BrnoMarsRover/myMachine-LED-cap/README.md

# myMachine-LED-cap
Repository for my Machine LED Cap project, including software, PCBs, and documentation.
