BrnoMarsRover/myMachine-LED-cap/docs/hardware/komponenty.md

## Komponenty
Všechny komponenty potřebné pro realizaci jedné LED kšiltovky. BOM pro desku plošných spojů bude generovat Kicad, proto je nebude zapisovat do této tabulky.

Primárně je snaha všechny komponenty vybírat z obchodu Mouser.com a LaskaKit.cz.

## Tabulka komponent
| Název | Obchod | Množství | Cena (ks) | Cena celkem | Poznámka |
|---|---|---|---|---|---|
|Kšitovka|-|-|-|-|Libovolně|
|[Displej](https://www.laskakit.cz/en/4-0--480x320-tft-displej--st7796--spi--dotykovy/)|LaskaKit|1|598 Kč|598 Kč|LA141073|
|[LED Neopixel](https://www.laskakit.cz/en/led-pasek-neopixel-ws2812b-144led-m-ip65-1m-cerny/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)|LaskaKit|1,2 m|488 Kč|586 Kč|LA145022F|
|[Motor](https://www.laskakit.cz/en/modul-ventilatoru-l9110/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)|LaskaKit|1|58 Kč|58 Kč|LA143011|
|[Switch](https://cz.mouser.com/ProductDetail/E-Switch/RD151C112F?qs=QtyuwXswaQg7j8DbOZUpHw%3D%3D)|Mouser electronics|1|19,81 Kč|19,81 Kč|612-RD151C112F|
|[Bateriový box](https://www.laskakit.cz/bateriovy-box-1x18650-dratove-vyvody/)|LaskaKit|2|12 Kč|24 Kč|LA123057|
|[Baterie Li-Ion](https://www.laskakit.cz/geb-li-ion-baterie-18650-3200mah-3-7v/)|LaskaKit|2|158 Kč|316 Kč|LA123134|
|[Dual-Lock zip](https://www.3market.cz/sj-3870-samolepici-suchy-zip-3m-dual-lock--lepeni-kovu--povrchu-s-praskovymi-laky--plastu-typu-plexiskla--polykarbonatu-a-abs--cena-za-bezny-m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)|3market|1 m|108,4 Kč|108,4 Kč|7100214419|
|[Vložka se závitem](https://cz.mouser.com/ProductDetail/SI/IUTB-M2.5?qs=7MVldsJ5UaxaLK8FbVq%252B7A%3D%3D)|Mouser electronics|8|9 Kč|72 Kč|153-IUTB-M2.5|
|[Distanční sloupek](https://cz.mouser.com/c/electromechanical/hardware/standoffs-spacers/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)|Mouser electronics|8|10 Kč|80 Kč|nutné doladit výšku podle možností  výrobku|
|-|-|-|-|-|-|

### Nabíjení
Nabíjení vybraných baterií bude probíhat externě. Může se koupit jakákoliv nabíječka na Li-Ion baterie jako například [zde](https://www.alza.cz//alzapower-usb-battery-charger-ap450b-d6154186.htm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), cena orietačně 700 - 800 Kč. Bude však stačit jedna nabíječka pro všechny kšiltovky.
