BrnoMarsRover/myMachine-LED-cap/docs/hardware/top_board/top_board.md

# Top board

## BOM

[Otevřít interaktivní BOM](ibom.html)

## Schéma

[Otevřít schéma](schematic_v0.0.pdf)

## Popis

Horní deska slouží ke dvěma účelům - zaprvé drží motor, zadruhé jsou na ní konektory k motoru a k ledpáskům.

Konektory jsou typu JST-XH. Samice se zapájí do desky. Samce bude potřeba nakrimpovat. 

Bude použit tento [motor](https://www.laskakit.cz/ga12-n20-6v-motor-s-prevodovkou/?variantId=1853) . Případně s podrobnějším výkresem [zde](https://www.aliexpress.com/item/1005010029527576.html). Na výstup převodovky se umístí vrtulka, která se pravděpodobně vytiskne. Zespodu má motor dva vývody, kterými bude připájen k desce. Mezi vývody je ale výstupek. Uprostřed desky tedy bude muset být otvor, kterým výstupek projde. Okraje otvoru budou zasahovat poměrně blízko k dírám pro připájení vývodů motoru. Kicad projekt s navrženou deskou je ve složce pcbs. Pokud by se objevil problém s deskou, jsem připraven pomoct s jeho řešením.
