BrnoMarsRover/myMachine-LED-cap/docs/updates.md

## 25.2.2026
Před osazovaním step-up modulu jej prosím nastavte tak, aby výstupní napětí bylo 5V [dle tohoto návodu](https://www.laskakit.cz/step-up-boost-menic-s-mt3608/).
```
Vyvarujte se stavu kdy je na vstupních svorkách vyšší napětí než nastavené na výstupních! Může dojít k poškození měniče!
Před prvním použitím je tedy nutné použít vstupní napětí 2V a nastavit požadované výstupní napětí. Potom lze na vstup připojit zamýšlené vyšší vstupní napětí.
```

## 19.2.2026
Až dorazí na plošné spoje a součástky (očekávám je tento možná příští týden). Je na střední škole, aby

- DPS osadila, doporučuji při osazovaní využívat iBOM, které je v dokumentaci k dispozici.
- Připravila všechny konektory (baterie, displej, LED pásek, motor ...) tak aby šel hardware testovat.

Jakmile bude hardware připraven vyzvedneme si ho a otestujeme. Proto prosím tyto kroky zbytečně neodkládat, ať se případné chyby v hardwaru mohou ještě opravit.

Mezi tím si potom střední škola může připravovat první prototyp kšitovky

- Tisk dílů ve fusion modelu (Možná ale budou upraveny po testování).
- Přišití suchých zipů na kšiltovku.
- Pokud by byl nějaký dobrovolník co by si chtěl vyzkoušet ten automatický šicí stroj ve FabLabu, tak se na kšitovku může vyšít nějaké pěkné logo.

## 11.2.2026
Byly objednány první verze DPS z obchodu JLCPCB. Byla objednána i deska top_board, jelikož cena byla pár dolarů navíc. Avšak stále se preferuje vyrobená varianta na střední škole.
