BrnoMarsRover/myMachine-LED-cap/docs/index.md

# My Machine LED kšiltovka

Vítej v dokumentaci projektu My Machine LED kšiltovka. Zde budeme postupně vkládat všechny potřebné materiály k tomuto projektu.

Všechny soubory k projektu budou k dispozici v našem githubovém repozitáři [BrnoMarsRover/myMachine-LED-cap](https://github.com/BrnoMarsRover/myMachine-LED-cap.git). Pro jeho stažení stačí rozkliknout zelené tlačítko 'code' a zvolit 'stáhnout zip'.

## Autoři
- Martin Kříž
- Martin Majnuš
- Vilém Strachoň
- Filip Šlíma
- Ondřej Štafa
