BrnoMarsRover/myMachine-LED-cap/docs/software/example.md

## Ukázka
Ukázkový kód pro ESP32 webserver je v [software/web-server-example](https://github.com/BrnoMarsRover/myMachine-LED-cap/tree/main/software/web-server-example).

## [Web pro ovládání kšiltovky](web_ukazka.html)

## Inspirace

- [https://www.youtube.com/watch?v=z-I-r3PX2lU](https://www.youtube.com/watch?v=z-I-r3PX2lU)
- [https://randomnerdtutorials.com/esp32-web-server-arduino-ide/](https://randomnerdtutorials.com/esp32-web-server-arduino-ide/)
