BrnoMarsRover/myMachine-LED-cap/docs/images/esp_pinout.jpg

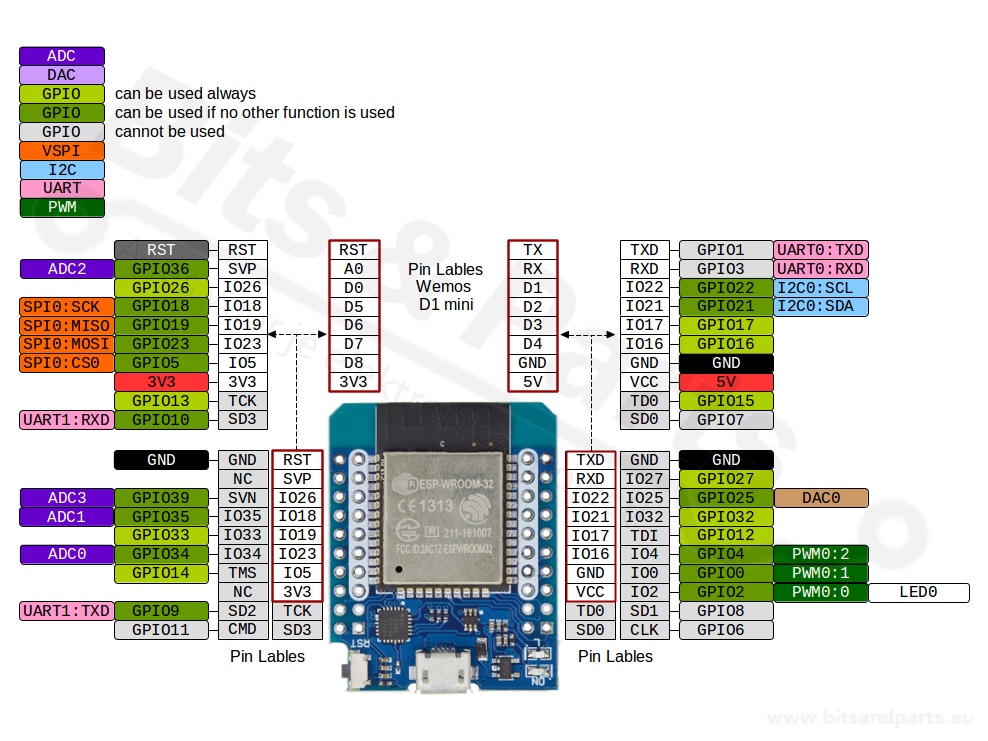
docs/images/esp_pinout.jpg
