BrnoMarsRover/myMachine-LED-cap/docs/construction/druhy_nakup.md

## Druhý nákup – LaskaKit

> **Doručit: střední škola**

Položky z obchodu [LaskaKit.cz](https://www.laskakit.cz) potřebné pro realizaci jedné LED kšiltovky.

## Tabulka komponent

| Název | Množství | Cena (ks) | Cena celkem | Kód | Poznámka |
|---|---|---|---|-----|---|
|[ESP32 Kit](https://www.laskakit.cz/en/mh-et-live-esp32-minikit--wemos-d1-mini-shield-kompatibilni/)|2|198 Kč|396 Kč|LA100089||
|[Displej](https://www.laskakit.cz/en/4-0--480x320-tft-displej--st7796--spi--dotykovy/)|2|598 Kč|1 196 Kč|LA141073||
|[LED Neopixel](https://www.laskakit.cz/en/led-pasek-neopixel-ws2812b-144led-m-ip65-1m-cerny/)|2 m|488 Kč/m|976 Kč|LA145022F||
|[Bateriový box](https://www.laskakit.cz/bateriovy-box-1x18650-dratove-vyvody/)|4|12 Kč|48 Kč|LA123057||
|[Baterie Li-Ion](https://www.laskakit.cz/geb-li-ion-baterie-18650-3200mah-3-7v/)|4|158 Kč|632 Kč|LA123134||
|[Krimpovací pin](https://www.laskakit.cz/pin-pro-konektor-jst-xh/)|100|1 Kč|100 Kč|LA217022||
|[Dupont lišta](https://www.laskakit.cz/yxcon-p125-1140a0bs116a1-dupont-kolikova-lista-40pin-2-54mm-pozlacena-jednorada-prima/)|2|14 Kč|28 Kč|LA217089B||

**Celkem: 3 376 Kč**

---

## 3market.cz

> **Doručit: střední škola**

| Název | Množství | Cena (bm) | Cena celkem | Kód |
|---|---|---|---|-----|
|[Dual-Lock zip](https://www.3market.cz/sj-3870-samolepici-suchy-zip-3m-dual-lock--lepeni-kovu--povrchu-s-praskovymi-laky--plastu-typu-plexiskla--polykarbonatu-a-abs--cena-za-bezny-m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)|4 m|108,4 Kč|433,6 Kč|7100214419|

**Celkem: 433,6 Kč**

---

## feromat.cz

> **Doručit: tým VUT**

| Název | Množství | Cena (ks) | Cena celkem | Poznámka |
|---|---|---|---|---|
|[Tavný závit M3 vysoký 3mm](https://www.tme.eu/cz/details/kvt-0006m3/zavitove-vlozky/tappex/0006m3/)|40|-|-|Display box|
|[Šroub M3 14mm](https://shop.feromat.cz/index.php?IdP=18&Akce=Obj&Hodnota=15000000035643&IdVyhlSloz=15000000039723)|20|-|-|Display box|
|[Distanční sloupek samice M3 8mm](https://www.tme.eu/cz/details/tff-m3x8_dr113bk/distancni-prvky-kovove/dremec/113x08sw/)|20|-|-|Display box|
|[Šroub M3 6mm zapuštěný](https://shop.feromat.cz/index.php?IdP=18&Akce=Obj&Hodnota=15000000039581&IdVyhlSloz=15000000227729)|10|-|-|Display box – Zdebjan řekne|
|[Matka M3](https://shop.feromat.cz/index.php?IdP=18&Akce=Obj&Hodnota=15000000034929&IdVyhlSloz=15000000908352)|10|-|-|Display box|
|[Šroub M3 6mm](https://shop.feromat.cz/index.php?IdP=18&Akce=Obj&Hodnota=15000000036193&IdVyhlSloz=15000000039723)|20|-|-|Display box|
|[Šroub M3 14mm](https://shop.feromat.cz/index.php?IdP=18&Akce=Obj&Hodnota=15000000035643&IdVyhlSloz=15000000039723)|15|-|-|Top box|
|[Matka M3](https://shop.feromat.cz/index.php?IdP=18&Akce=Obj&Hodnota=15000000034929&IdVyhlSloz=15000000908352)|15|-|-|Top box|
|[Podložka M3](https://shop.feromat.cz/index.php?IdP=18&Akce=Obj&Hodnota=15000000035422&IdVyhlSloz=15000000035418)|15|-|-|Top box|

---

## Nákupní košík – Mouser

> **Doručit: tým VUT**

[Otevřít sdílený košík na Mouser.com](https://cz.mouser.com/api/CrossDomain/GetContext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)
