BrnoMarsRover/myMachine-LED-cap/docs/construction/komponenty.md

## Komponenty
Všechny komponenty potřebné pro realizaci jedné LED kšiltovky. Seznam součástek pro PCB je k dispozici jako odkaz v tabulce komponent.

Primárně je snaha všechny komponenty vybírat z obchodu Mouser.com a LaskaKit.cz. A dodatečně byl ještě přidán obchod TME.eu

## Tabulka komponent
| Název | Obchod | Množství | Cena (ks) | Cena celkem | Poznámka |
|---|---|---|---|---|---|
|[Kšiltovka](https://www.bezpotisku.cz/produkt/ksiltovka-buzz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)|Bezpotisku|1|99 Kč|99 Kč|Může být i jiná|
|[Displej](https://www.laskakit.cz/en/4-0--480x320-tft-displej--st7796--spi--dotykovy/)|LaskaKit|1|598 Kč|598 Kč|LA141073|
|[LED Neopixel](https://www.laskakit.cz/en/led-pasek-neopixel-ws2812b-144led-m-ip65-1m-cerny/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)|LaskaKit|1,2 m|488 Kč|586 Kč|LA145022F (kupme 2m)|
|[Bateriový box](https://www.laskakit.cz/bateriovy-box-1x18650-dratove-vyvody/)|LaskaKit|2|12 Kč|24 Kč|LA123057|
|[Baterie Li-Ion](https://www.laskakit.cz/geb-li-ion-baterie-18650-3200mah-3-7v/)|LaskaKit|2|158 Kč|316 Kč|LA123134|
|[Krimpovací pin](https://www.laskakit.cz/pin-pro-konektor-jst-xh/)|LaskaKit|50|1 Kč|50 Kč|LA217022|
|[Dupont lišta](https://www.laskakit.cz/yxcon-p125-1140a0bs116a1-dupont-kolikova-lista-40pin-2-54mm-pozlacena-jednorada-prima/)|LaskaKit|1|14 Kč|14 Kč|LA217089B|
|[Nabíječka](https://www.laskakit.cz/en/nabijecka-liitokala-lii-pd4-pro-li-ion--li-fe-a-ni-mh-baterie/)|LaskaKit|1|668|668|LA123099|
|[Dual-Lock zip](https://www.3market.cz/sj-3870-samolepici-suchy-zip-3m-dual-lock--lepeni-kovu--povrchu-s-praskovymi-laky--plastu-typu-plexiskla--polykarbonatu-a-abs--cena-za-bezny-m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)|3market|2 m|108,4 Kč|216,8 Kč|7100214419|
|[Switch](https://cz.mouser.com/ProductDetail/E-Switch/RD151C112F?qs=QtyuwXswaQg7j8DbOZUpHw%3D%3D)|Mouser|1|19,81 Kč|19,81 Kč|612-RD151C112F|
|[Vložka se závitem](https://cz.mouser.com/ProductDetail/SI/IUTB-M2.5?qs=7MVldsJ5UaxaLK8FbVq%252B7A%3D%3D)|Mouser|8|9 Kč|72 Kč|153-IUTB-M2.5|
|[Distanční sloupek](https://cz.mouser.com/c/electromechanical/hardware/standoffs-spacers/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)|Mouser|8|10 Kč|80 Kč|zatím nekupovat|
|[Plochý kabel](https://cz.mouser.com/ProductDetail/3M-Electronic-Solutions-Division/3302-10-CUT-LENGTH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)|Mouser|3|17 Kč|51 Kč|517-3302/10FT|
|[BOM Main PCB](../hardware/main_board/ibom.html)|Mouser/LaskaKit|1|-|1064 Kč|BOM generované v KiCad *|
|[BOM Top PCB](../hardware/top_board/ibom.html)|Mouser/LaskaKit|1|-|121 Kč|BOM generované v KiCad|
|[8 pin JST-XH](https://www.tme.eu/cz/details/xhp-8/signalove-konektory-raster-2-50mm/jst/)|TME|1|2,06 Kč|2,06 Kč|XHP-8|
|[3 pin JST-XH](https://www.tme.eu/cz/details/xhp-3/signalove-konektory-raster-2-50mm/jst/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)|TME|5|1,46 Kč|7,3 Kč|XHP-3|
|[2 pin JST-XH](https://www.tme.eu/cz/details/xhp-2/signalove-konektory-raster-2-50mm/jst/)|TME|5|1,17 Kč|5,85 Kč|XHP-2|
|Display box|-|1|-|-|3D tisk|
|Main PCB|-|1|-|-|Objedná se|
|Top box|-|1|-|-|3D tisk|
|Top PCB|-|1|-|-|Vyrobí se|
|-|-|-|-|-|-|

- *Pojistku (652-SF-0603F500-2) je vhodné zakoupit alespoň 5x

### Nabíjení
Nabíjení vybraných baterií bude probíhat externě. Může se koupit jakákoliv nabíječka na Li-Ion baterie jako například [zde](https://www.laskakit.cz/en/nabijecka-liitokala-lii-pd4-pro-li-ion--li-fe-a-ni-mh-baterie/), cena orietačně 700 - 800 Kč. Bude však stačit jedna nabíječka pro všechny kšiltovky.
