BrnoMarsRover/myMachine-LED-cap/docs/hardware/top_board/schematic_v0.0.pdf

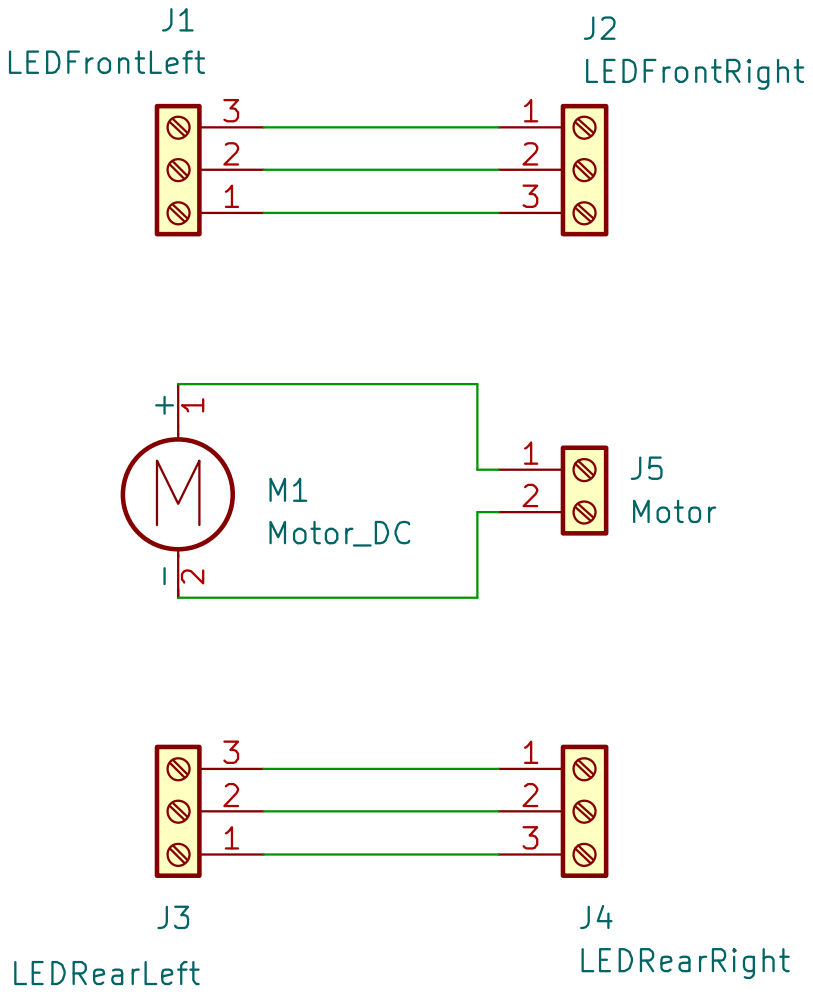
[picture p5: page 1]
