BrnoMarsRover/myMachine-LED-cap/pcbs/top_board/tob_board/tob_board.kicad_pcb

## KiCad design pcbs/top_board/tob_board/tob_board.kicad_pcb (2026-03-12)

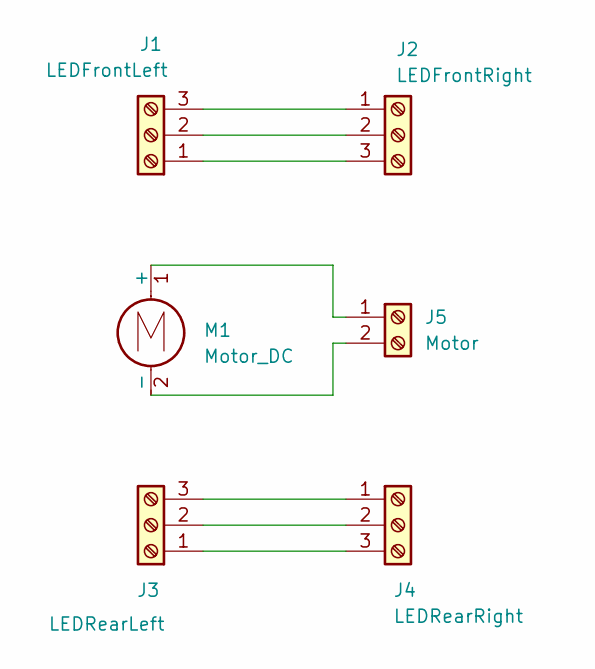
[picture p12: schematic tob_board.kicad_sch, Top board - MyMachine LED cap]

Parts:
J1: LEDFrontLeft; JST_XH_S3B-XH-A_1x03_P2.50mm_Horizontal; Manufacturer Part Number S3B-XH-A-1 (LF)(SN)
J2: LEDFrontRight; JST_XH_S3B-XH-A_1x03_P2.50mm_Horizontal; Manufacturer Part Number S3B-XH-A-1 (LF)(SN)
J3: LEDRearLeft; JST_XH_S3B-XH-A_1x03_P2.50mm_Horizontal; Manufacturer Part Number S3B-XH-A-1 (LF)(SN)
J4: LEDRearRight; JST_XH_S3B-XH-A_1x03_P2.50mm_Horizontal; Manufacturer Part Number S3B-XH-A-1 (LF)(SN)
J5: Motor; JST_XH_S2B-XH-A_1x02_P2.50mm_Horizontal; Manufacturer Part Number S2B-XH-A-BK(LF)(SN)
M1: Motor_DC; topMotor; Manufacturer Part Number LA143024A

Connections:
unnamed: J1.1, J2.3
unnamed: J1.2, J2.2
unnamed: J1.3, J2.1
unnamed: J3.1, J4.3
unnamed: J3.2, J4.2
unnamed: J3.3, J4.1
unnamed: J5.1, M1.1 (+)
unnamed: J5.2, M1.2 (-)

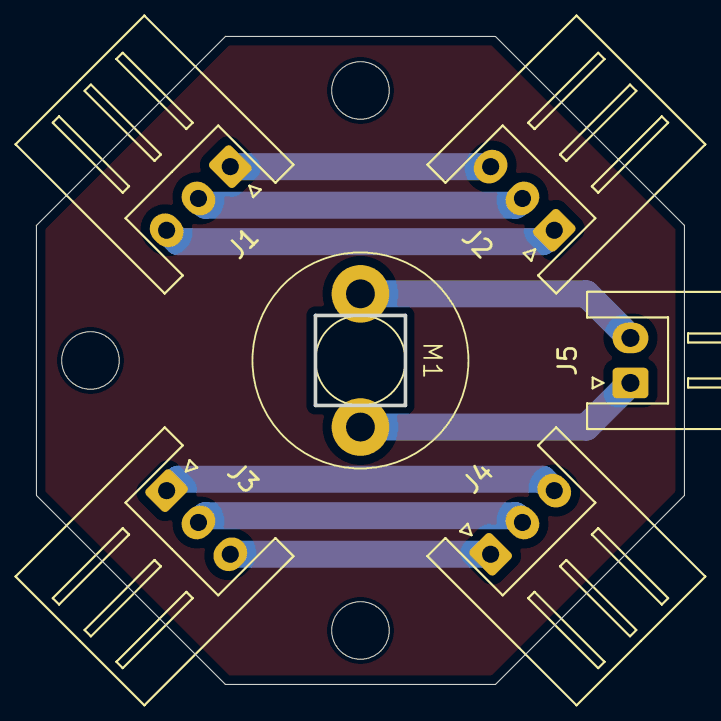
[picture p13: board tob_board.kicad_pcb from above]

Board: 2 copper layers, 36.0 x 36.0 mm, 6 parts (0 on the bottom side), 8 nets.
