BrnoMarsRover/myMachine-LED-cap/pcbs/main_board/main_board.kicad_pcb

## KiCad design pcbs/main_board/main_board.kicad_pcb (2026-03-12)

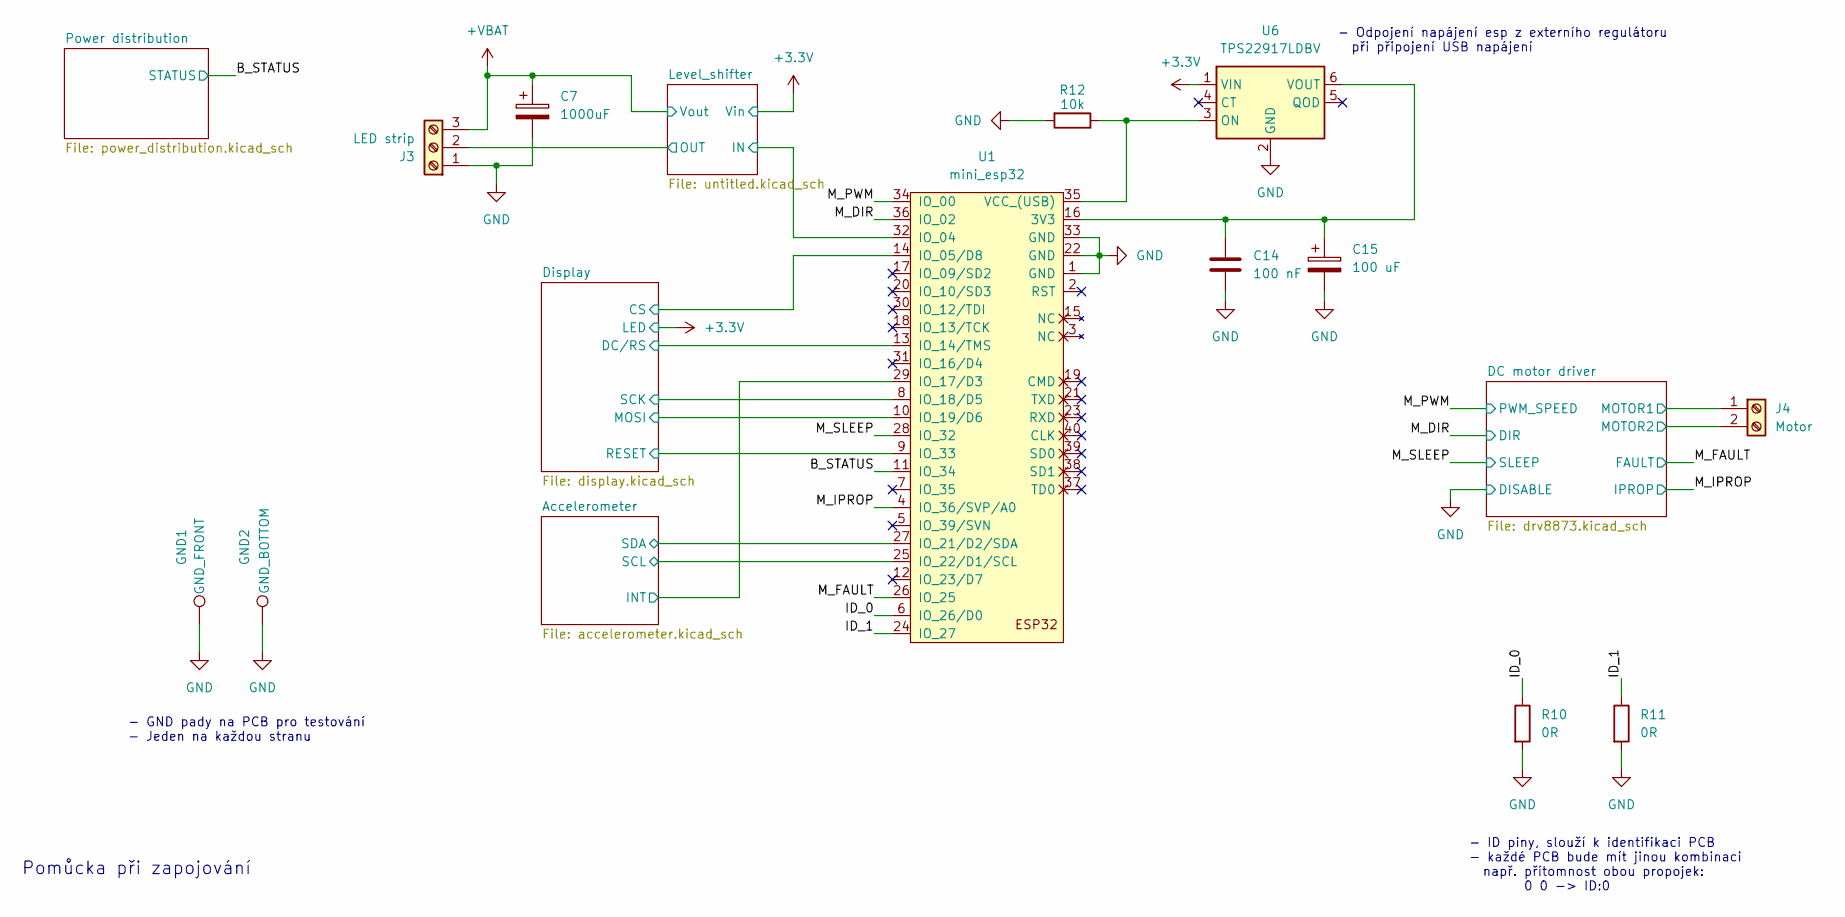
[picture p14: schematic main_board.kicad_sch, Main board - MyMachine LED cap]

Parts:
C7: 1000uF; CP_EIA-7360-38_Kemet-E_HandSolder; Manufacturer Part Number TCN4108M006R0055
C14: 100 nF; C_0603_1608Metric_Pad1.08x0.95mm_HandSolder; Manufacturer Part Number C0603C104M5RACTU
C15: 100 uF; CP_EIA-7343-40_Kemet-Y_HandSolder; Manufacturer Part Number T491X107K016AT7280
GND1: GND_FRONT; TestPoint_Pad_1.5x1.5mm
GND2: GND_BOTTOM; TestPoint_Pad_1.5x1.5mm
J3: LED strip; JST_XH_S3B-XH-A-1_1x03_P2.50mm_Horizontal; Manufacturer Part Number S3B-XH-A-1 (LF)(SN)
J4: Motor; JST_XH_S2B-XH-A-1_1x02_P2.50mm_Horizontal; Manufacturer Part Number S2B-XH-A-BK(LF)(SN)
R10, R11: 0R; R_0603_1608Metric_Pad0.98x0.95mm_HandSolder; Manufacturer Part Number CRCW06030000Z0EI
R12: 10k; R_0603_1608Metric_Pad0.98x0.95mm_HandSolder; Manufacturer Part Number CRCW060310K0FKEI
U1: mini_esp32; ESP32_mini; Manufacturer Part Number LA100089
U6: TPS22917LDBV; SOT-23-6; Manufacturer Part Number TPS22917LDBVR

Connections:
+3.3V: U6.1 (VIN); also elsewhere on the board
+VBAT: C7.1, J3.3; also elsewhere on the board
/Accelerometer/INT: U1.29 (IO_17/D3); also elsewhere on the board
/Accelerometer/SCL: U1.25 (IO_22/D1/SCL); also elsewhere on the board
/Accelerometer/SDA: U1.27 (IO_21/D2/SDA); also elsewhere on the board
/B_STATUS: U1.11 (IO_34); also elsewhere on the board
/DC motor driver/MOTOR1: J4.1; also elsewhere on the board
/DC motor driver/MOTOR2: J4.2; also elsewhere on the board
/Display/CS: U1.14 (IO_05/D8); also elsewhere on the board
/Display/DC/RS: U1.13 (IO_14/TMS); also elsewhere on the board
/Display/MOSI: U1.10 (IO_19/D6); also elsewhere on the board
/Display/RESET: U1.9 (IO_33); also elsewhere on the board
/Display/SCK: U1.8 (IO_18/D5); also elsewhere on the board
/ID_0: R10.1, U1.6 (IO_26/D0)
/ID_1: R11.1, U1.24 (IO_27)
/Level_shifter/IN: U1.32 (IO_04); also elsewhere on the board
/Level_shifter/OUT: J3.2; also elsewhere on the board
/M_DIR: U1.36 (IO_02); also elsewhere on the board
/M_FAULT: U1.26 (IO_25); also elsewhere on the board
/M_IPROP: U1.4 (IO_36/SVP/A0); also elsewhere on the board
/M_PWM: U1.34 (IO_00); also elsewhere on the board
/M_SLEEP: U1.28 (IO_32); also elsewhere on the board
GND: C7.2, C14.2, C15.2, GND1.1, GND2.1, J3.1, R10.2, R11.2, R12.2, U1.1 (GND), U1.22 (GND), U1.33 (GND), U6.2 (GND); also elsewhere on the board
unnamed: C14.1, C15.1, U1.16 (3V3), U6.6 (VOUT)
unnamed: R12.1, U1.35 (VCC_(USB)), U6.3 (ON)

Notes on the sheet:
Pomůcka při zapojování
- Odpojení napájení esp z externího regulátoru při připojení USB napájení
- ID piny, slouží k identifikaci PCB - každé PCB bude mít jinou kombinaci např. přítomnost obou propojek: 0 0 -> ID:0
- GND pady na PCB pro testování - Jeden na každou stranu

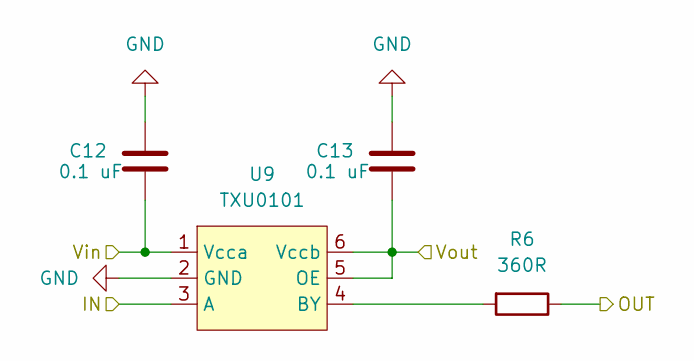
[picture p15: schematic untitled.kicad_sch, Main board - MyMachine LED cap]

Parts:
C12, C13: 0.1 uF; C_0603_1608Metric_Pad1.08x0.95mm_HandSolder; Manufacturer Part Number CC0603JRX7R9BB104
R6: 360R; R_0603_1608Metric_Pad0.98x0.95mm_HandSolder; Manufacturer Part Number CRCW0603360RJNTA
U9: TXU0101; SOT-363_SC-70-6_Handsoldering; Manufacturer Part Number TXU0101DCKR

Connections:
+3.3V: C12.1, U9.1 (Vcca); also elsewhere on the board
+VBAT: C13.1, U9.5 (OE), U9.6 (Vccb); also elsewhere on the board
/Level_shifter/IN: U9.3 (A); also elsewhere on the board
/Level_shifter/OUT: R6.1; also elsewhere on the board
GND: C12.2, C13.2, U9.2 (GND); also elsewhere on the board
unnamed: R6.2, U9.4 (BY)

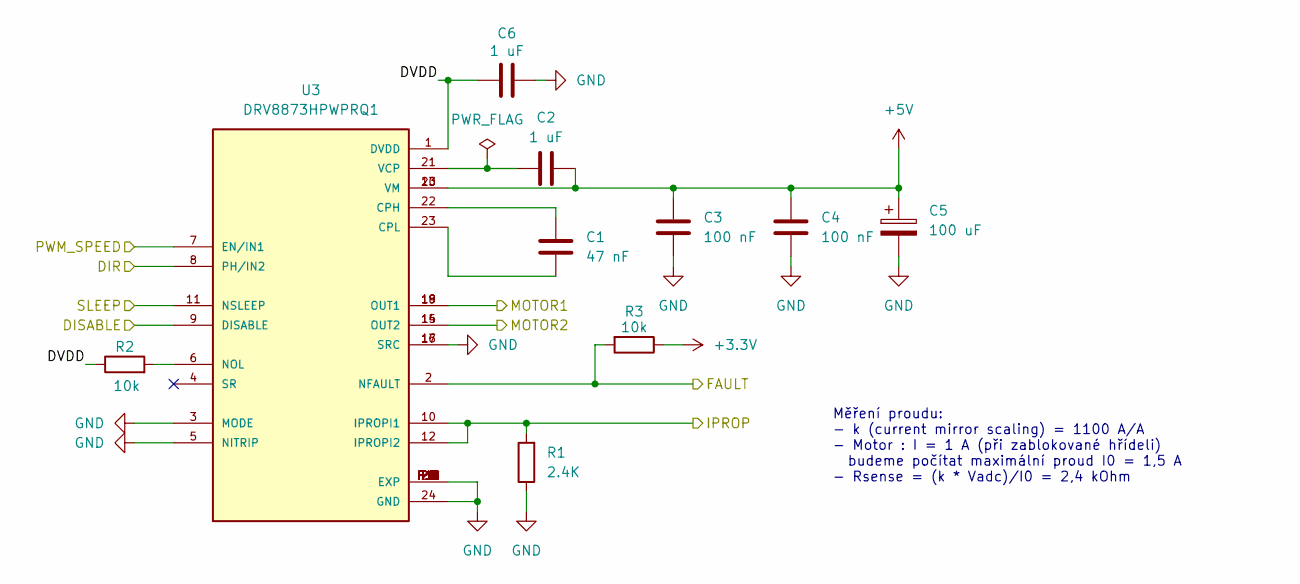
[picture p16: schematic drv8873.kicad_sch, Main board - MyMachine LED cap]

Parts:
C1: 47 nF; C_0603_1608Metric_Pad1.08x0.95mm_HandSolder; Manufacturer Part Number CC0603ZRY5V9BB473
C2, C6: 1 uF; C_0603_1608Metric_Pad1.08x0.95mm_HandSolder; Manufacturer Part Number CC0603KRX5R6BB105
C3, C4: 100 nF; C_0603_1608Metric_Pad1.08x0.95mm_HandSolder; Manufacturer Part Number C0603C104M5RACTU
C5: 100 uF; CP_EIA-7343-40_Kemet-Y_HandSolder; Manufacturer Part Number T491X107K016AT7280
R1: 2.4K; R_0603_1608Metric_Pad0.98x0.95mm_HandSolder; Manufacturer Part Number AR0603JR-072K4L
R2, R3: 10k; R_0603_1608Metric_Pad0.98x0.95mm_HandSolder; Manufacturer Part Number CRCW060310K0FKEI
U3: DRV8873HPWPRQ1; SOP65P640X120-25N; Manufacturer Part Number DRV8873HPWPR

Connections:
+3.3V: R3.1; also elsewhere on the board
+5V: C2.2, C3.1, C4.1, C5.1, U3.13 (VM), U3.20 (VM); also elsewhere on the board
/DC motor driver/DVDD: C6.1, R2.1, U3.1 (DVDD)
/DC motor driver/MOTOR1: U3.18 (OUT1), U3.19 (OUT1); also elsewhere on the board
/DC motor driver/MOTOR2: U3.14 (OUT2), U3.15 (OUT2); also elsewhere on the board
/M_DIR: U3.8 (PH/IN2); also elsewhere on the board
/M_FAULT: R3.2, U3.2 (NFAULT); also elsewhere on the board
/M_IPROP: R1.2, U3.10 (IPROPI1), U3.12 (IPROPI2); also elsewhere on the board
/M_PWM: U3.7 (EN/IN1); also elsewhere on the board
/M_SLEEP: U3.11 (NSLEEP); also elsewhere on the board
GND: C3.2, C4.2, C5.2, C6.2, R1.1, U3.3 (MODE), U3.5 (NITRIP), U3.9 (DISABLE), U3.16 (SRC), U3.17 (SRC), U3.24 (GND), U3.25 (EXP), U3.P1 (EXP), U3.P2 (EXP), U3.P3 (EXP), U3.P4 (EXP), U3.P5 (EXP), U3.P6 (EXP), U3.P7 (EXP), U3.P8 (EXP), U3.P9 (EXP), U3.P10 (EXP), U3.P11 (EXP), U3.P12 (EXP), U3.P13 (EXP), U3.P14 (EXP), U3.P15 (EXP), U3.P16 (EXP), U3.P17 (EXP), U3.P18 (EXP); also elsewhere on the board
unnamed: C1.1, U3.22 (CPH)
unnamed: C1.2, U3.23 (CPL)
unnamed: R2.2, U3.6 (NOL)
unnamed: C2.1, U3.21 (VCP)

Notes on the sheet:
Měření proudu: - k (current mirror scaling) = 1100 A/A - Motor : I = 1 A (při zablokované hřídeli) budeme počítat maximální proud I0 = 1,5 A - Rsense = (k * Vadc)/I0 = 2,4 kOhm

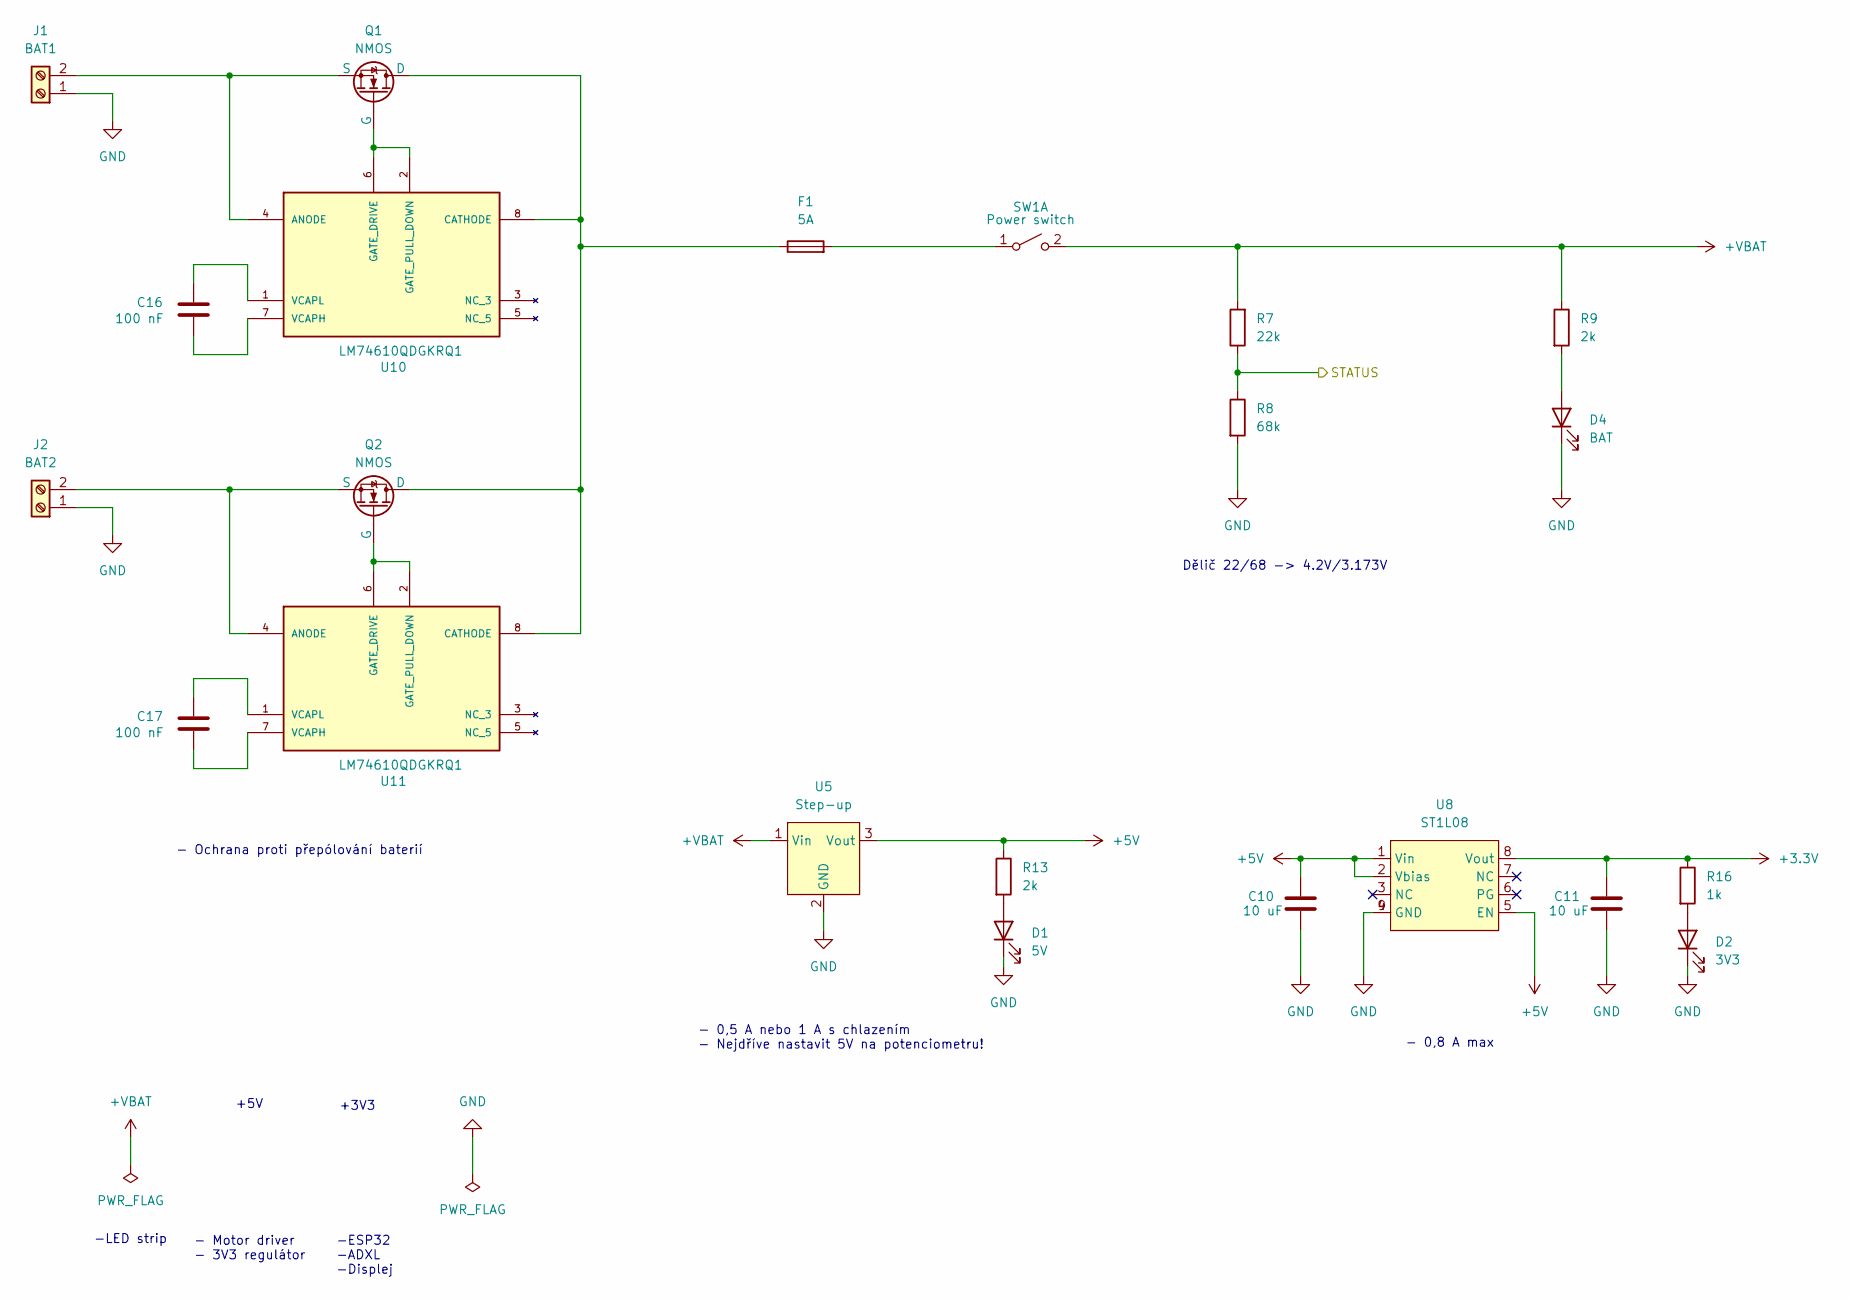
[picture p17: schematic power_distribution.kicad_sch, Main board - MyMachine LED cap]

Parts:
C10, C11: 10 uF; C_0603_1608Metric_Pad1.08x0.95mm_HandSolder; Manufacturer Part Number C0603C106M8PAC7411
C16, C17: 100 nF; C_0603_1608Metric_Pad1.08x0.95mm_HandSolder; Manufacturer Part Number C0603C104M5RACTU
D1: 5V; LED_0805_2012Metric_Pad1.15x1.40mm_HandSolder; Manufacturer Part Number APTD2012LCGCK
D2: 3V3; LED_0805_2012Metric_Pad1.15x1.40mm_HandSolder; Manufacturer Part Number APTD2012LCGCK
D4: BAT; LED_0805_2012Metric_Pad1.15x1.40mm_HandSolder; Manufacturer Part Number APTD2012LCGCK
F1: 5A; Fuse_0603_1608Metric_Pad1.05x0.95mm_HandSolder; Manufacturer Part Number SF-0603F500-2
J1: BAT1; JST_XH_S2B-XH-A-1_1x02_P2.50mm_Horizontal; Manufacturer Part Number S2B-XH-A-BK(LF)(SN)
J2: BAT2; JST_XH_S2B-XH-A-1_1x02_P2.50mm_Horizontal; Manufacturer Part Number S2B-XH-A-BK(LF)(SN)
Q1, Q2: NMOS; SO-8_3.9x4.9mm_P1.27mm; Manufacturer Part Number IRF8714TRPBFXTMA1
R7: 22k; R_0603_1608Metric_Pad0.98x0.95mm_HandSolder; Manufacturer Part Number CRCW060322K0FKEBC
R8: 68k; R_0603_1608Metric_Pad0.98x0.95mm_HandSolder; Manufacturer Part Number CRCW060368K0FKTA
R9, R13: 2k; R_0603_1608Metric_Pad0.98x0.95mm_HandSolder; Manufacturer Part Number AR0603FR-072KL
R16: 1k; R_0603_1608Metric_Pad0.98x0.95mm_HandSolder; Manufacturer Part Number RC0603FR-071KL
SW1: Power switch; JST_XH_S2B-XH-A-1_1x02_P2.50mm_Horizontal; Manufacturer Part Number S2B-XH-A-BK(LF)(SN)
U5: Step-up; step-up_module; Manufacturer Part Number LA122015
U8: ST1L08; DFN-8-1EP_3x2mm_P0.5mm_EP1.3x1.5mm; Manufacturer Part Number ST1L08SPU33R
U10, U11: LM74610QDGKRQ1; SOP65P490X110-8N; Manufacturer Part Number LM74610QDGKRQ1

Connections:
+3.3V: C11.2, R16.1, U8.8 (Vout); also elsewhere on the board
+5V: C10.2, R13.1, U5.3 (Vout), U8.1 (Vin), U8.2 (Vbias), U8.5 (EN); also elsewhere on the board
+VBAT: R7.2, R9.1, SW1.2 (B), U5.1 (Vin); also elsewhere on the board
/B_STATUS: R7.1, R8.1; also elsewhere on the board
GND: C10.1, C11.1, D1.1 (K), D2.1 (K), D4.1 (K), J1.1, J2.1, R8.2, U5.2 (GND), U8.4 (GND), U8.9 (GND); also elsewhere on the board
unnamed: D1.2 (A), R13.2
unnamed: D2.2 (A), R16.2
unnamed: D4.2 (A), R9.2
unnamed: J1.2, Q1.1 (S), Q1.2 (S), Q1.3 (S), U10.4 (ANODE)
unnamed: J2.2, Q2.1 (S), Q2.2 (S), Q2.3 (S), U11.4 (ANODE)
unnamed: Q1.4 (G), U10.2 (GATE_PULL_DOWN), U10.6 (GATE_DRIVE)
unnamed: Q2.4 (G), U11.2 (GATE_PULL_DOWN), U11.6 (GATE_DRIVE)
unnamed: F1.2, SW1.1 (A)
unnamed: F1.1, Q1.5 (D), Q1.6 (D), Q1.7 (D), Q1.8 (D), Q2.5 (D), Q2.6 (D), Q2.7 (D), Q2.8 (D), U10.8 (CATHODE), U11.8 (CATHODE)
unnamed: C16.1, U10.7 (VCAPH)
unnamed: C16.2, U10.1 (VCAPL)
unnamed: C17.1, U11.7 (VCAPH)
unnamed: C17.2, U11.1 (VCAPL)

Notes on the sheet:
-ESP32 -ADXL -Displej
-LED strip
+3V3
- Motor driver - 3V3 regulátor
+5V
- 0,8 A max
- 0,5 A nebo 1 A s chlazením - Nejdříve nastavit 5V na potenciometru!
Dělič 22/68 -> 4.2V/3.173V
- Ochrana proti přepólování baterií

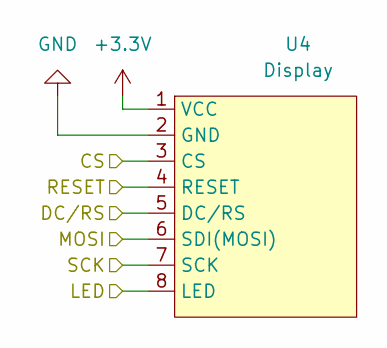
[picture p18: schematic display.kicad_sch, Main board - MyMachine LED cap]

Parts:
U4: Display; JST_XH_S8B-XH-A-1_1x08_P2.50mm_Horizontal; Manufacturer Part Number S8B-XH-A-1 (LF)(SN)

Connections:
+3.3V: U4.1 (VCC), U4.8 (LED); also elsewhere on the board
/Display/CS: U4.3 (CS); also elsewhere on the board
/Display/DC/RS: U4.5 (DC/RS); also elsewhere on the board
/Display/MOSI: U4.6 (SDI(MOSI)); also elsewhere on the board
/Display/RESET: U4.4 (RESET); also elsewhere on the board
/Display/SCK: U4.7 (SCK); also elsewhere on the board
GND: U4.2 (GND); also elsewhere on the board

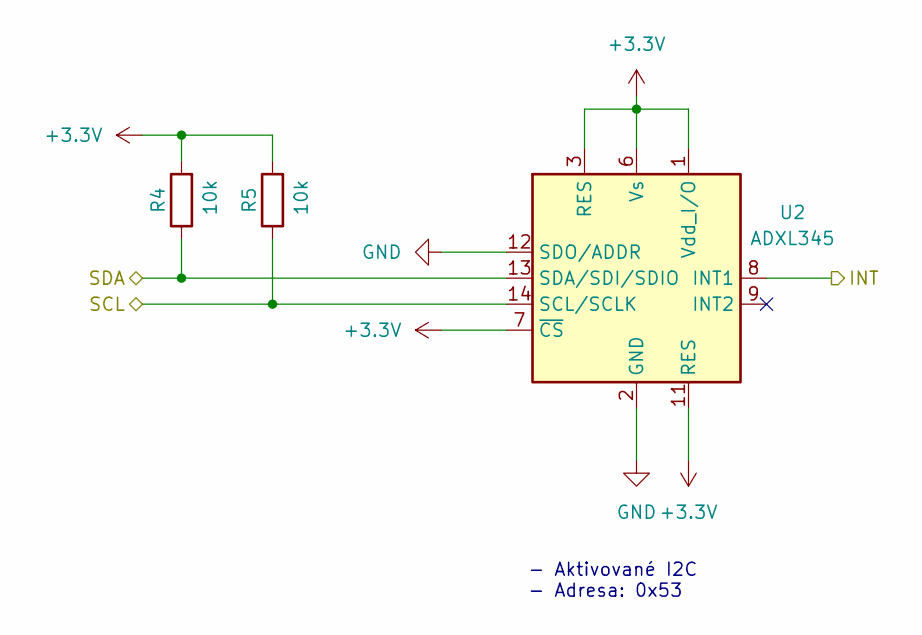
[picture p19: schematic accelerometer.kicad_sch, Main board - MyMachine LED cap]

Parts:
R4, R5: 10k; R_0603_1608Metric_Pad0.98x0.95mm_HandSolder; Manufacturer Part Number CRCW060310K0FKEI
U2: ADXL345; LGA-14_3x5mm_P0.8mm_LayoutBorder1x6y; Manufacturer Part Number ADXL345BCCZ

Connections:
+3.3V: R4.2, R5.2, U2.1 (Vdd_I/O), U2.3 (RES), U2.6 (Vs), U2.7 (~CS), U2.11 (RES); also elsewhere on the board
/Accelerometer/INT: U2.8 (INT1); also elsewhere on the board
/Accelerometer/SCL: R5.1, U2.14 (SCL/SCLK); also elsewhere on the board
/Accelerometer/SDA: R4.1, U2.13 (SDA/SDI/SDIO); also elsewhere on the board
GND: U2.2 (GND), U2.4 (GND), U2.5 (GND), U2.12 (SDO/ADDR); also elsewhere on the board

Notes on the sheet:
- Aktivované I2C - Adresa: 0x53

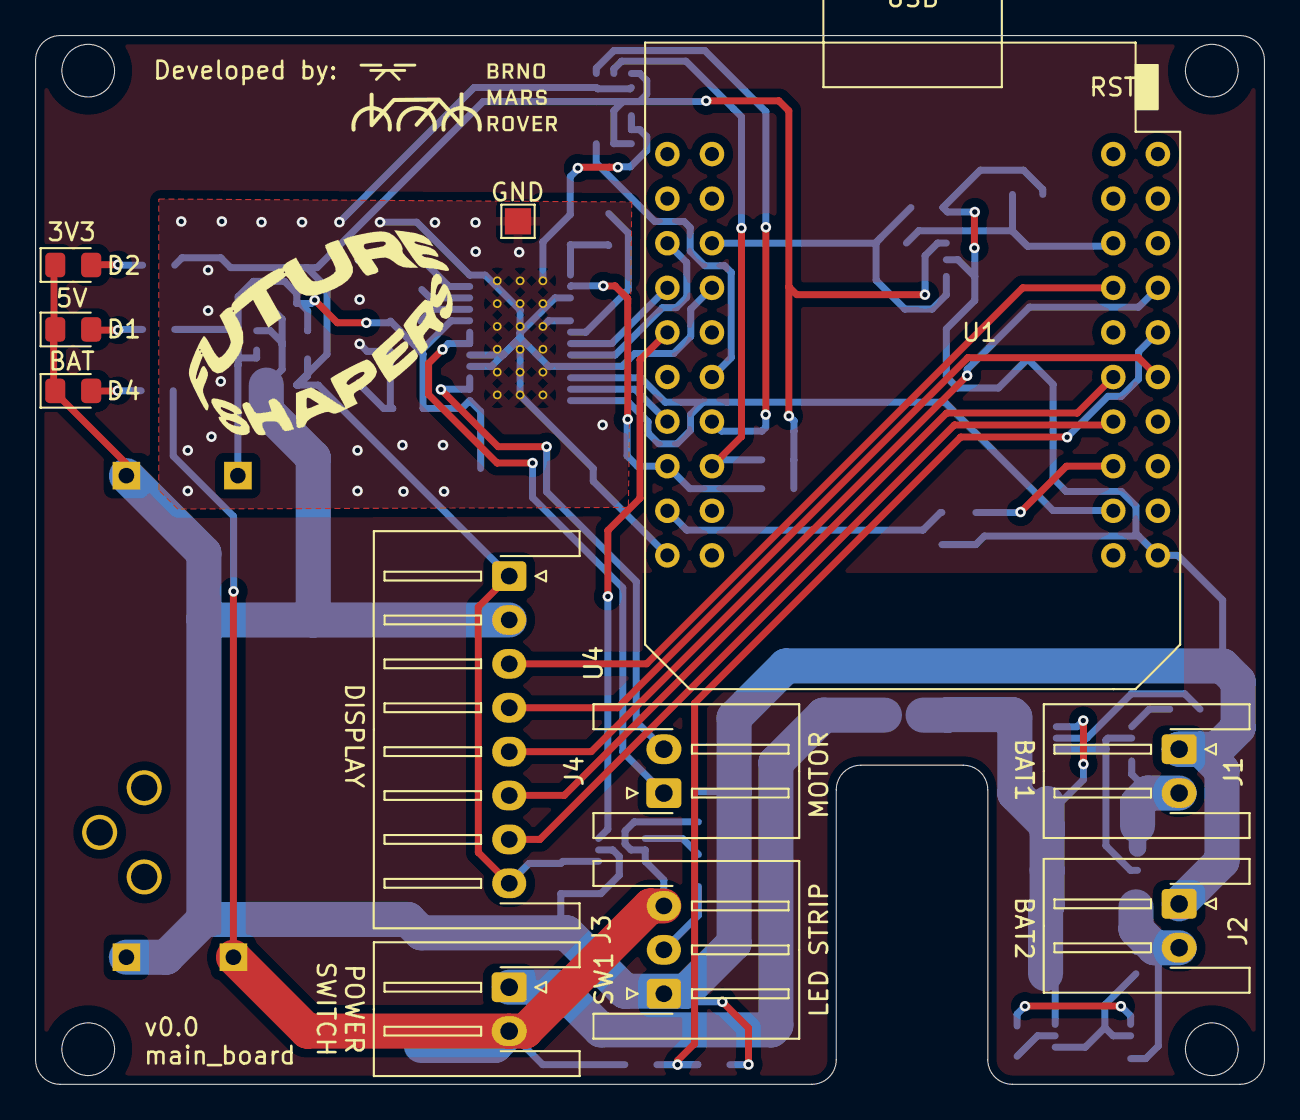
[picture p20: board main_board.kicad_pcb from above]

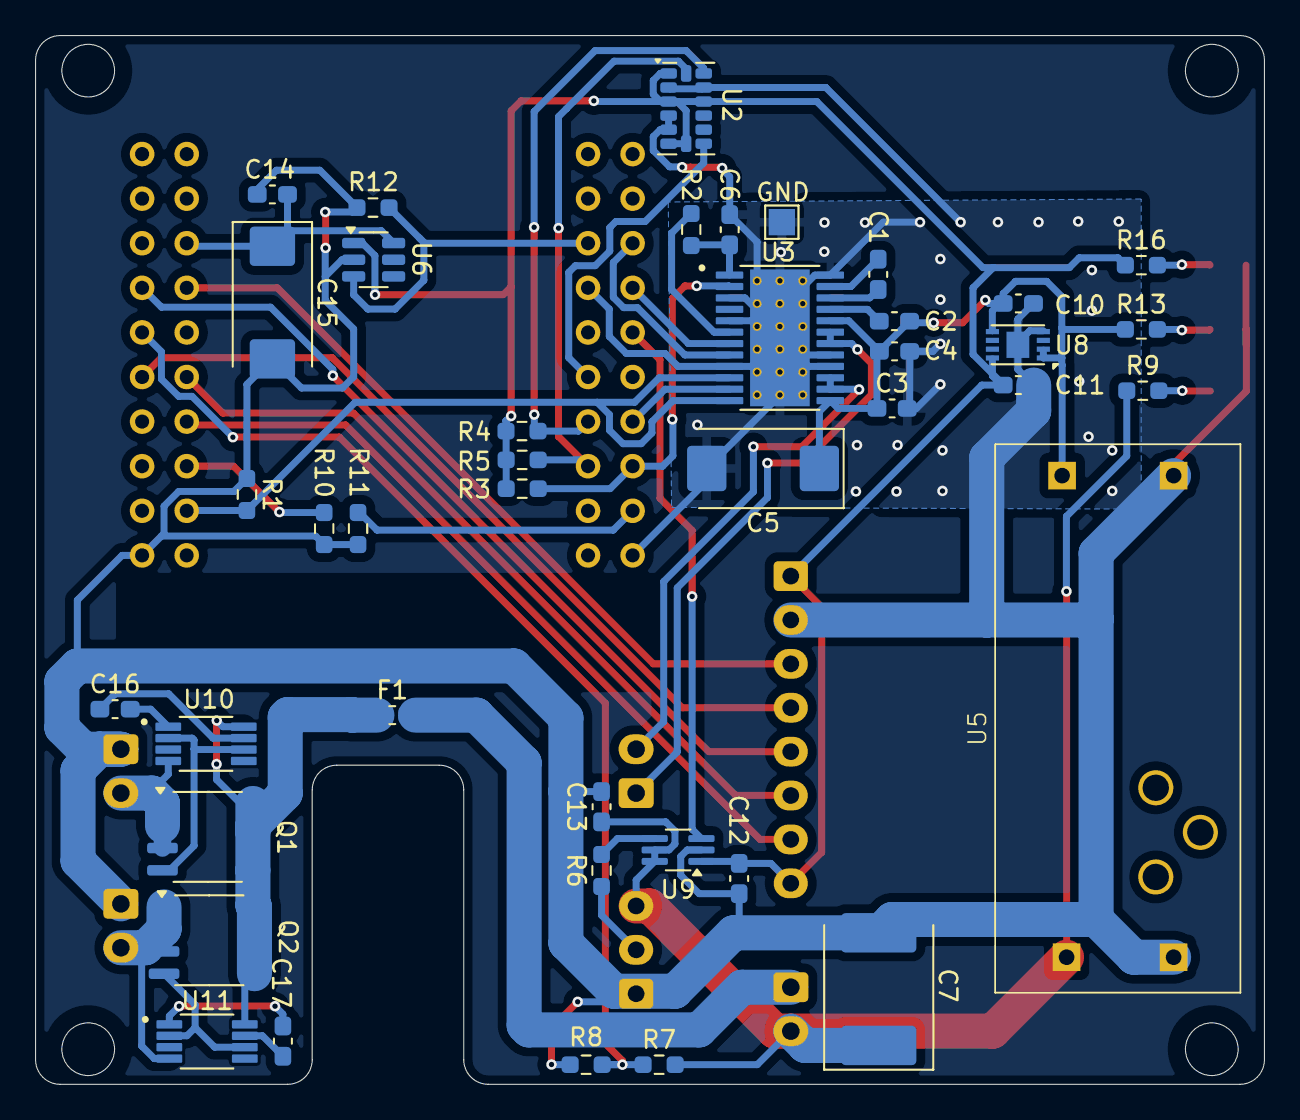
[picture p21: board main_board.kicad_pcb from below]

Board: 2 copper layers, 70.0 x 59.7 mm, 56 parts (41 on the bottom side), 45 nets.

Other parts of the board:
H3, H3#2, H3#3, H3#4: MountingHole; MountingHole_3.2mm_M3
