BrnoMarsRover/myMachine-LED-cap/software/myMachine_LED_cap/include/DisplayTFT.h

#pragma once
#include <Arduino.h>
#include <SPI.h>
#include <Adafruit_GFX.h>
#include <Adafruit_ST7796S.h>

#include "config.h"
#include "ws_protocol.h"

class DisplayTFT {
public:
    bool begin();
    void showImage(const uint16_t* img, uint16_t w, uint16_t h);
    void clear(uint16_t color = ST77XX_WHITE);
    void handleDraw(const DrawMsg& m);
    void showConnectInfo(const char* ssid, const char* pass, const char* ip);
    void showBatteryLow();
    // Nakreslí horizont čáru – half_dy = kolik px se pravý konec zvedne / levý sníží
    // Automaticky maže předchozí polohu. Reset při zavolání clear().
    void drawHorizonLine(int half_dy);

private:
    Adafruit_ST7796S tft = Adafruit_ST7796S(TFT_CS, TFT_DC, TFT_RST);

    bool penDown = false;
    int lastX = 0, lastY = 0;
    int _lastHorizonDy = 32767;  // sentinel = ještě nebylo nakresleno

    static inline int mapX(int x) { return (x * DISP_W) / CANVAS_W; }
    static inline int mapY(int y) { return (y * DISP_H) / CANVAS_H; }

    uint16_t rgb565_from_hex(const String& hex);
    void drawThickLine(int x0, int y0, int x1, int y1, uint16_t color, int thickness);
};
