BrnoMarsRover/myMachine-LED-cap/software/myMachine_LED_cap/include/WebUI.h

#pragma once
#include <Arduino.h>
#include <WiFi.h>
#include <AsyncTCP.h>
#include <ESPAsyncWebServer.h>

#include "config.h"
#include "pins.h"
#include "ws_protocol.h"
#include "modes.h"

typedef void (*DrawMsgCallback)(const DrawMsg& msg);

class WebUI {
public:
    void begin(const char* ssid, DrawMsgCallback cb);
    void loop();

private:
    AsyncWebServer server = AsyncWebServer(80);
    AsyncWebSocket ws     = AsyncWebSocket("/ws");
    DrawMsgCallback onDraw = nullptr;

    void onWsEvent(AsyncWebSocket* server,
                   AsyncWebSocketClient* client,
                   AwsEventType type,
                   void* arg,
                   uint8_t* data,
                   size_t len);
};
