BrnoMarsRover/myMachine-LED-cap/(commit log)

2025-11-23 Add first components
    [drv8873.kicad_sch, main_board.kicad_pcb, main_board.kicad_sch]
2025-12-22 Add display footprint, symbol
    [main_board.kicad_sch]
2025-12-22 Add power distribution sheet
    [drv8873.kicad_sch, main_board.kicad_sch, power_distribution.kicad_sch]
2025-12-23 Add step-up into project
    [power_distribution.kicad_sch]
2025-12-23 Display wiring to esp
    [accelerometer.kicad_sch, display.kicad_sch, main_board.kicad_sch]
2025-12-23 Add led strip wiring
    [accelerometer.kicad_sch, main_board.kicad_sch]
2025-12-23 added top board
    [tob_board.kicad_pcb, tob_board.kicad_sch]
2025-12-25 wire m driver to esp
    [drv8873.kicad_sch, main_board.kicad_sch]
2025-12-27 Add ideal diode
    [main_board.kicad_sch, power_distribution.kicad_sch]
2025-12-28 Add files via upload
    switch and zip update
2025-12-29 board update
    [tob_board.kicad_pcb, tob_board.kicad_sch]
2025-12-29 Add reverse polarity protection
    [display.kicad_sch, main_board.kicad_sch, power_distribution.kicad_sch]
2025-12-30 Add connectors
    [display.kicad_sch, main_board.kicad_sch, power_distribution.kicad_sch]
2025-12-30 Changed pinout
    [main_board.kicad_sch]
2025-12-30 ID pins, BOM, fuse
    [main_board.kicad_sch, power_distribution.kicad_sch, tob_board.kicad_sch]
2026-01-09 ESP power update
    [drv8873.kicad_sch, main_board.kicad_sch, power_distribution.kicad_sch]
2026-01-10 Add IC for charging
    [main_board.kicad_sch, power_distribution.kicad_sch]
2026-01-10 Add 3V3 regulator
    [main_board.kicad_sch, power_distribution.kicad_sch]
2026-01-11 Add edge cuts and notes to pcb
    [display.kicad_sch, drv8873.kicad_sch, main_board.kicad_pcb, main_board.kicad_sch, power_distribution.kicad_sch, tob_board.kicad_sch]
2026-01-12 Add top board BOM
    [tob_board.kicad_pcb]
2026-01-14 Change 3V3 regulator, add level shifter for led strip
    [main_board.kicad_pcb, main_board.kicad_sch, power_distribution.kicad_sch, untitled.kicad_sch]
2026-01-15 Add LED indicators
    [main_board.kicad_pcb, main_board.kicad_sch, power_distribution.kicad_sch]
2026-01-15 Add tmp BOM of main board
    [power_distribution.kicad_sch]
2026-01-18 fix otaceni a ukladani
    [config.h, display_tft.cpp, display_tft.h, ksiltofka.ino, web_pages.cpp, web_ui.cpp, web_ui.h]
2026-01-19 Components update
    [accelerometer.kicad_sch, display.kicad_sch, drv8873.kicad_sch, main_board.kicad_pcb, main_board.kicad_sch, power_distribution.kicad_sch, tob_board.kicad_pcb, tob_board.kicad_sch]
2026-01-20 Main board final update
    [accelerometer.kicad_sch, display.kicad_sch, drv8873.kicad_sch, main_board.kicad_pcb, main_board.kicad_sch, power_distribution.kicad_sch, untitled.kicad_sch]
2026-01-20 Add schematic of main board
2026-01-20 Add top board schematic
    [tob_board.kicad_sch]
2026-01-23 changed footprint of level shifter
    [main_board.kicad_pcb, untitled.kicad_sch]
2026-02-09 Main board layout design
    [main_board.kicad_pcb]
2026-02-10 Main_board pcb v0.0
    [main_board.kicad_pcb]
2026-02-10 add gerbers
    [tob_board.kicad_pcb]
2026-03-12 Fix bom errors - main board
    [accelerometer.kicad_sch, drv8873.kicad_sch, main_board.kicad_pcb, main_board.kicad_sch, power_distribution.kicad_sch]
2026-03-12 thicker connections for easier manufacture
    [tob_board.kicad_pcb]
2026-03-20 Code update
    [partitions.csv]
2026-03-22 Add tmp BOM
2026-03-26 added accelerometer test data
2026-03-27 Add login page, imu data update
